mountainGoat2/Project_Bobik/20231214_182314.jpg

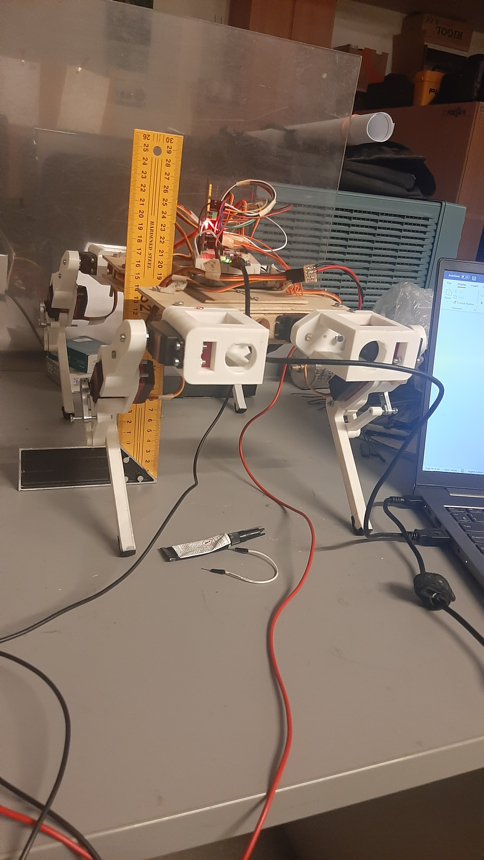
20231214_182314.jpg
