mountainGoat2/Project_Bobik/20231211_192234.jpg

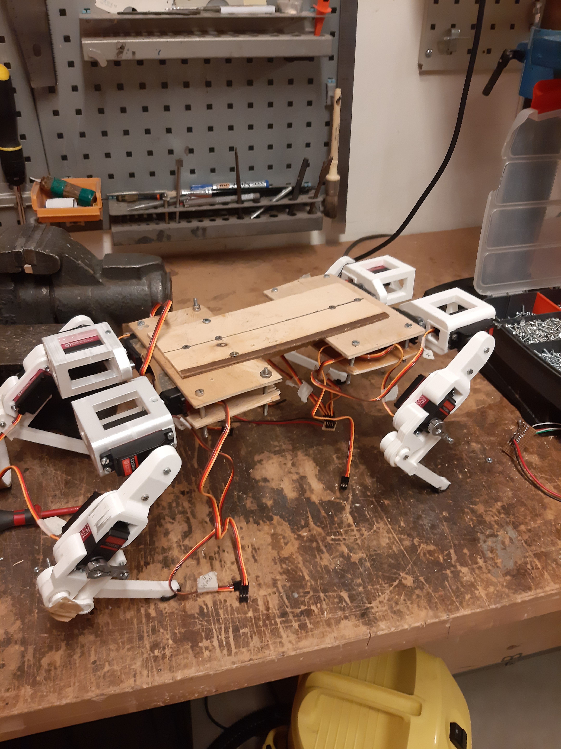
20231211_192234.jpg
