mountainGoat2/Project_Bobik/robot_V2.SLDASM

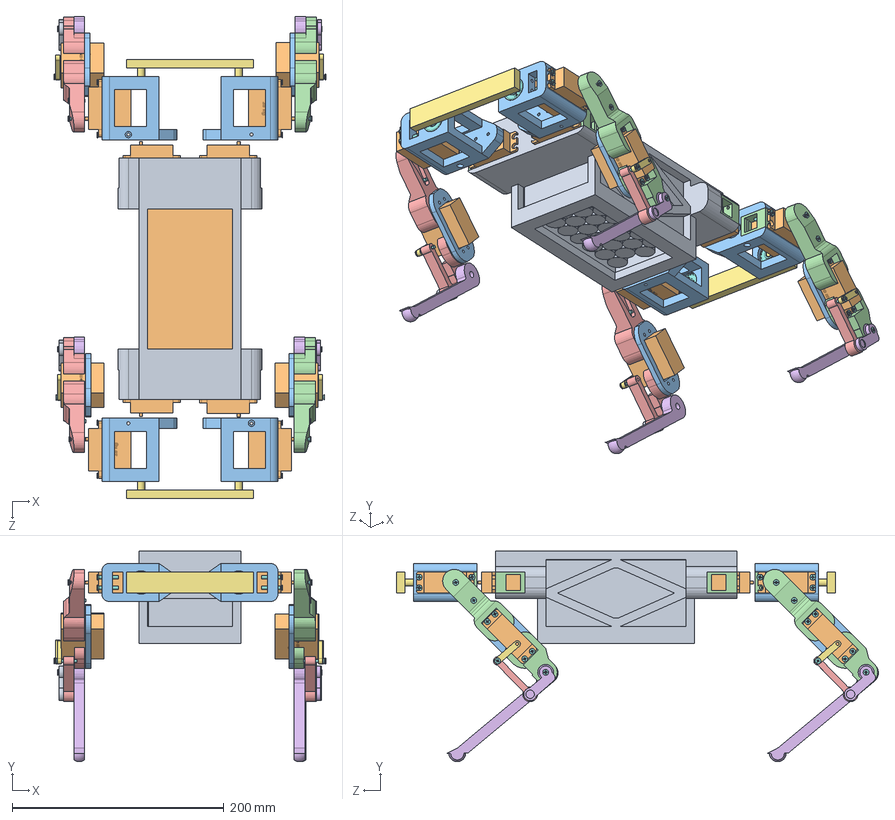
[picture p3: CAD file, 2024-03-28]
robot_V2.SLDASM
256.5 x 198.8 x 455.1 mm
skeleton
servo 25kg x 12
shoulder 2ndmotor mount x 4
Upper_limb_V2 x 2
transmission arm x 4
lower_limb_V2 x 2
25T_servo x 4
countersunk flat head cross recess screw_iso x 45
battery pack
to close the battery pack
upper_limb_V2_motorholds_restrainer x 4
shoulder_mount_holder x 8
Upper_limb_right_V2 x 2
lower_limb_right_V2 x 2
2shoulder_hold x 2
608 - 2RS x 4
lower_limb_V2 - Copy x 2
