mountainGoat2/Project_Bobik/Electrical_schematic_Bobik.pdf

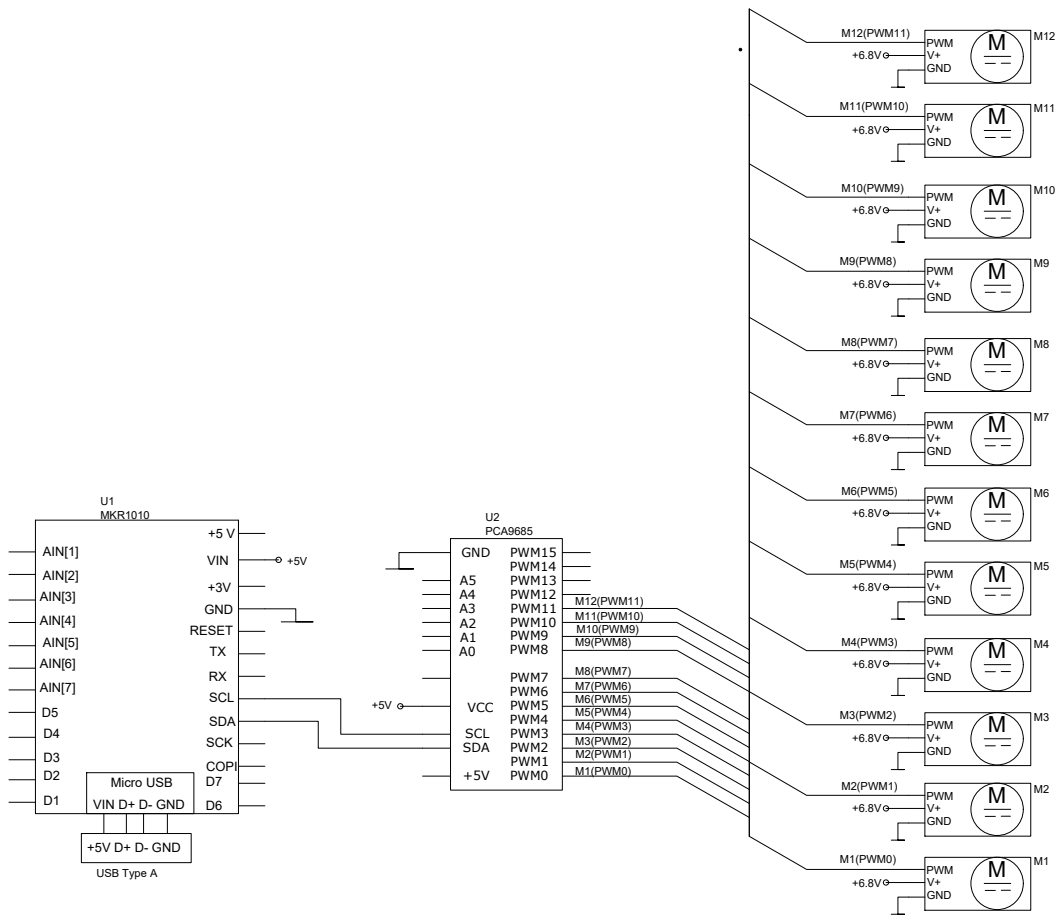
[picture p4: page 1]

AECA0 24.006.00.00.00.E2

Nr. | Page | Docum. Nr. | Signature
Performed
Supervisor
Checked by

Servo actuated quadruped robot functional electirical schematic

RTU IEEI
